hoangnguyen2000/my-proj/P41-22584 CUC CANH MOC KHOA W++/P41-22584 CUC CANH MOC KHOA W++.md

#### 1. Bản vẽ 

{expand}

<pdf>P41-22584 CUC CANH MOC KHOA W++.pdf</pdf>

{/expand}

#### 2. Tiêu chí kiểm tra đầu vào

##### 2.1. Kiểm tra ngoại quan
<table>
    <colgroup>
        <col width="100" />
        <col width="500" />
        <col width="500" />
    </colgroup>
    <tr>
        <th>STT</th>
        <th><center>Tiêu chí</center></th>
        <th><center>Hình ảnh</center></th>
    </tr>
    <tr>
        <td>1</td>
        <td>- Bề anode đen đều, không trầy xước<br /></td>
        <td>
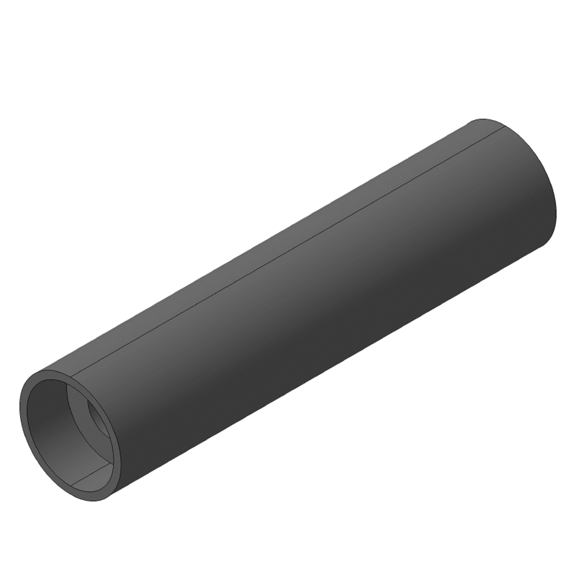
[picture p1: P41-22584 CUC CANH MOC KHOA W++/CUC CANH MOC KHOA W++.png]
            
        </td>
    </tr>
    <tr>
        <td>2</td>
        <td>- Đã xử lý bavia</td>
        <td></td>
    </tr>
</table>

##### 2.2. Kiểm tra kích thước chỉ định

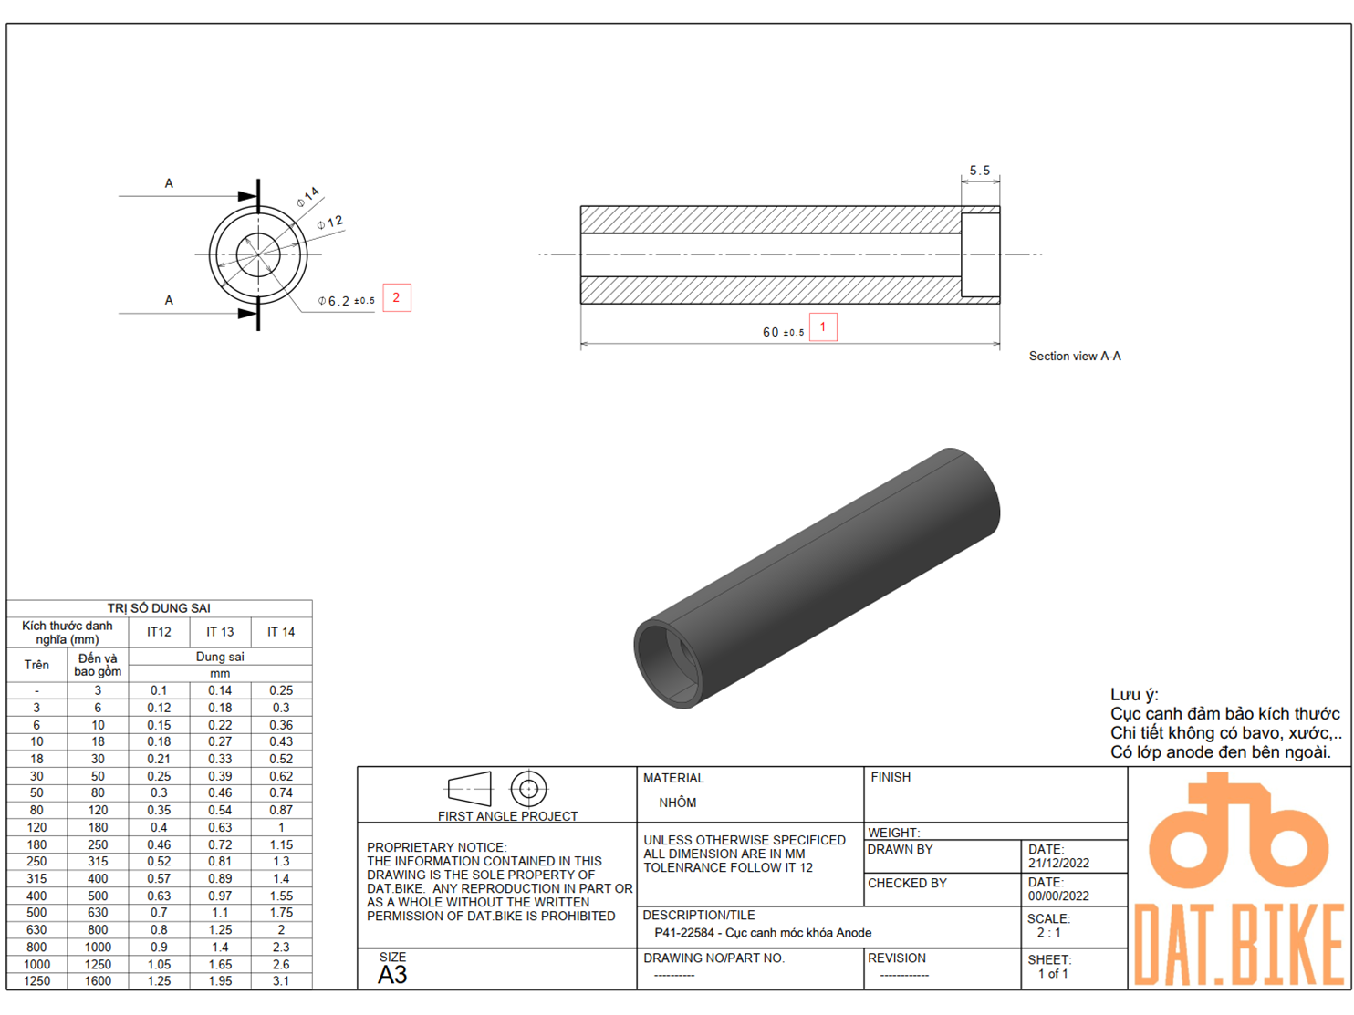
[picture p2: P41-22584 CUC CANH MOC KHOA W++/IQC CUC CANH MOC KHOA W++.png]


<table>
    <colgroup>
        <col width="100" />
        <col width="500" />
        <col width="275" />
        <col width="275" />
    </colgroup>
    <tr>
        <th>Điểm</th>
        <th><center>Kích thước</center></th>
        <th><center>Dung sai trên</center></th>
        <th><center>Dung sai dưới</center></th>
    </tr>
    <tr>
        <td><center>1</center></td>
        <td><center>60</center></td>
        <td><center>+0.5</center></td>
        <td><center>-0.5</center></td>
    </tr>
    <tr>
        <td><center>2</center></td>
        <td><center>6.2</center></td>
        <td><center>+0.5</center></td>
        <td><center>-0.5</center></td>
    </tr>
   
    </tr>
</table>

##### 2.3. Kiểm tra chức năng
<table>
    <colgroup>
        <col width="100" />
        <col width="500" />
    </colgroup>
    <tr>
        <th>STT</th>
        <th><center>Tiêu chí</center></th>
    </tr>
    <tr>
        <td>1</td>
        <td>- Lắp ráp vào Tab hộp sạc và móc treo đồ trên W++ </td>
    </tr>
</table>
