hoangnguyen2000/my-proj/P41-123 LOXO CHAN CHONG DUNG W++/P41-123 LOXO CHAN CHONG.md

#### 1. Bản vẽ 

{expand}

<pdf>PDF LO XO CHAN CHONG DUNG_LO_XO_CHAN_CHONG_DUNG_W++_V2_(105mm,phi3,16).pdf</pdf>

{/expand}

#### 2. Tiêu chí kiểm tra đầu vào

##### 2.1. Kiểm tra ngoại quan
<table>
    <colgroup>
        <col width="100" />
        <col width="500" />
        <col width="500" />
    </colgroup>
    <tr>
        <th>STT</th>
        <th><center>Tiêu chí</center></th>
        <th><center>Hình ảnh</center></th>
    </tr>
    <tr>
        <td>1</td>
        <td>- Bề mặt sơn đen nhám, không trầy xước<br /></td>
        <td>
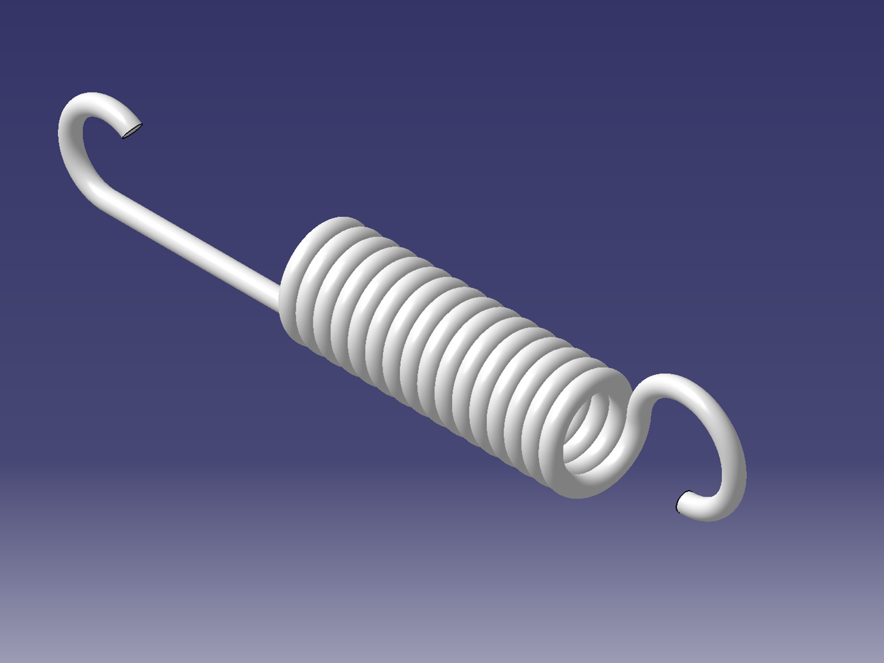
[picture p3: P41-123 LOXO CHAN CHONG DUNG W++/image (4).png]
            
        </td>
    </tr>
    <tr>
        <td>2</td>
        <td>- Đã xử lý bavia</td>
        <td></td>
    </tr>
</table>

##### 2.2. Kiểm tra kích thước chỉ định

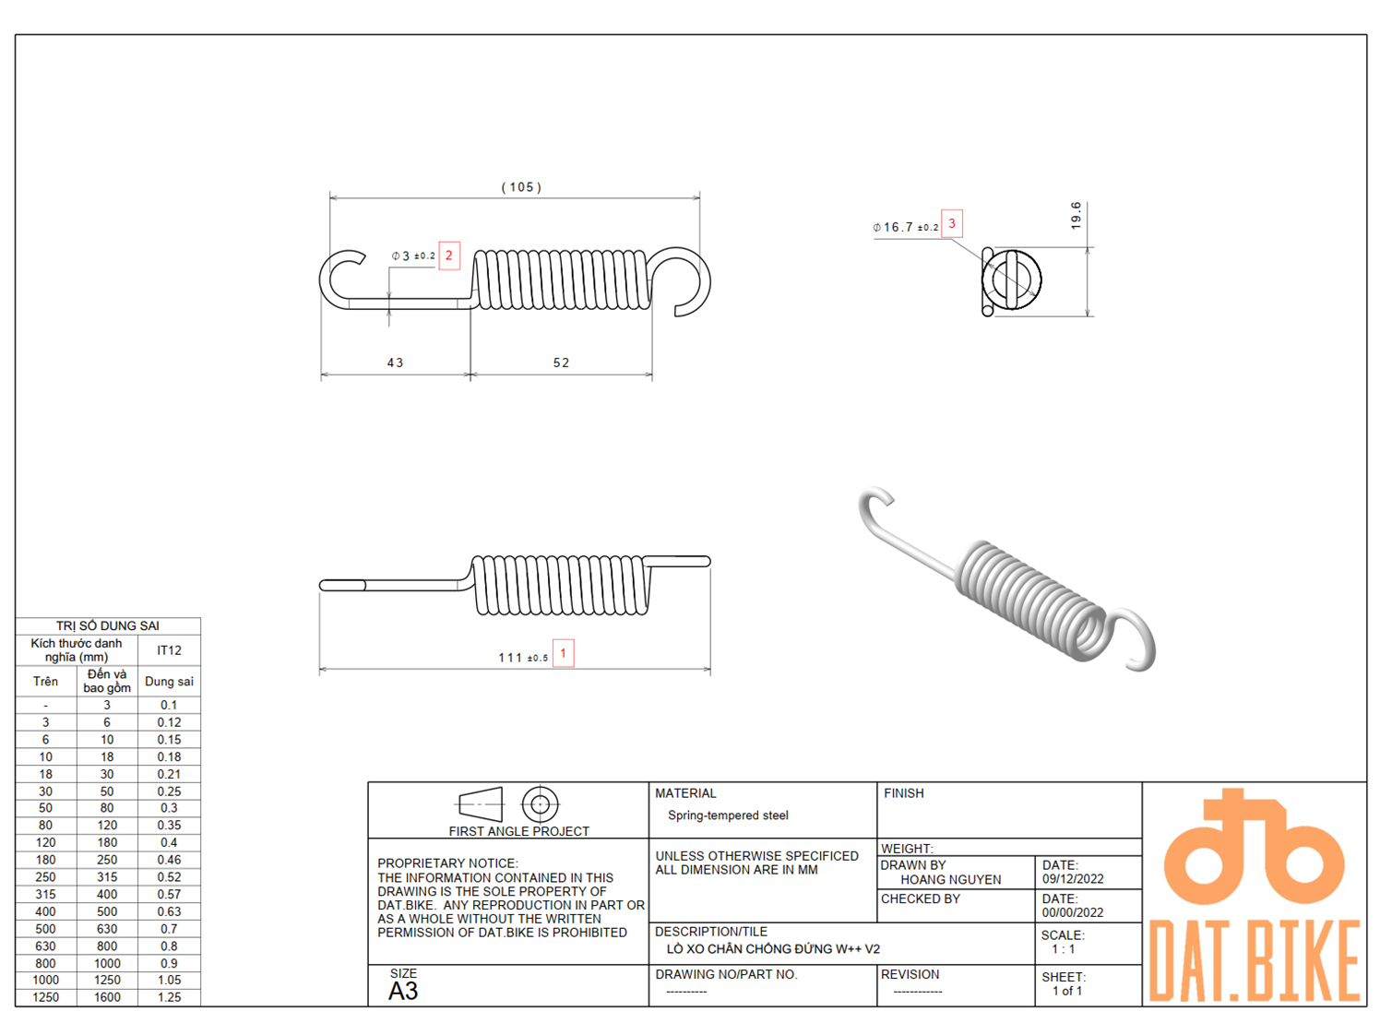
[picture p4: P41-123 LOXO CHAN CHONG DUNG W++/image (1).png]


<table>
    <colgroup>
        <col width="100" />
        <col width="500" />
        <col width="275" />
        <col width="275" />
    </colgroup>
    <tr>
        <th>Điểm</th>
        <th><center>Kích thước</center></th>
        <th><center>Dung sai trên</center></th>
        <th><center>Dung sai dưới</center></th>
    </tr>
    <tr>
        <td><center>1</center></td>
        <td><center>111</center></td>
        <td><center>+0.5</center></td>
        <td><center>-0.5</center></td>
    </tr>
    <tr>
        <td><center>2</center></td>
        <td><center>3</center></td>
        <td><center>+0.2</center></td>
        <td><center>-0.2</center></td>
    </tr>
   <tr>
        <td><center>3</center></td>
        <td><center>16.7</center></td>
        <td><center>+0.2</center></td>
        <td><center>-0.2</center></td>
    </tr>
    </tr>
</table>

##### 2.3. Kiểm tra chức năng
<table>
    <colgroup>
        <col width="100" />
        <col width="500" />
    </colgroup>
    <tr>
        <th>STT</th>
        <th><center>Tiêu chí</center></th>
    </tr>
    <tr>
        <td>1</td>
        <td>- Lắp rắp với chân chống đứng W++ và trục chân chống đứng </td>
    </tr>
</table>
