hoangnguyen2000/my-proj/P41-764940 OP NHONG DONG CO/P41-764940 op nhong truoc.md

#### 1. Bản vẽ 

{expand}

<pdf>PAD OP NHONG DONG CO_Sheet_1.pdf</pdf>

{/expand}

#### 2. Tiêu chí kiểm tra đầu vào

##### 2.1. Kiểm tra ngoại quan
<table>
    <colgroup>
        <col width="100" />
        <col width="500" />
        <col width="500" />
    </colgroup>
    <tr>
        <th>STT</th>
        <th><center>Tiêu chí</center></th>
        <th><center>Hình ảnh</center></th>
    </tr>
    <tr>
        <td>1</td>
        <td>- Bề mặt sơn đen nhám, không trầy xước<br /></td>
        <td>
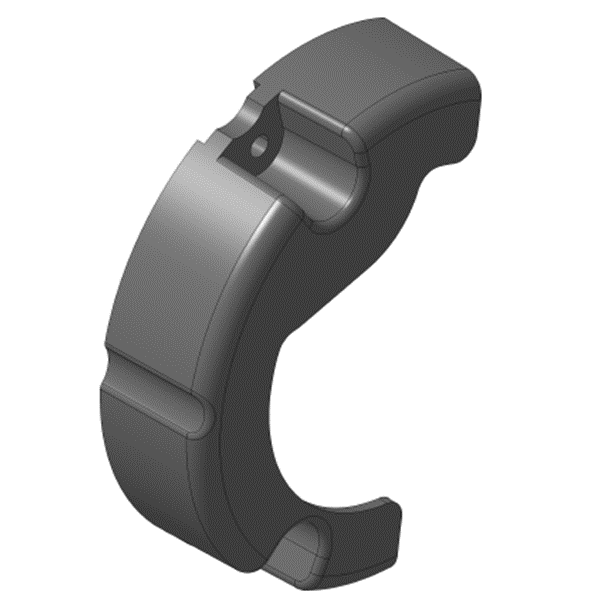
[picture p5: P41-764940 OP NHONG DONG CO/image (3).png]
            
        </td>
    </tr>
    <tr>
        <td>2</td>
        <td>- Đã xử lý bavia</td>
        <td></td>
    </tr>
</table>

##### 2.2. Kiểm tra kích thước chỉ định

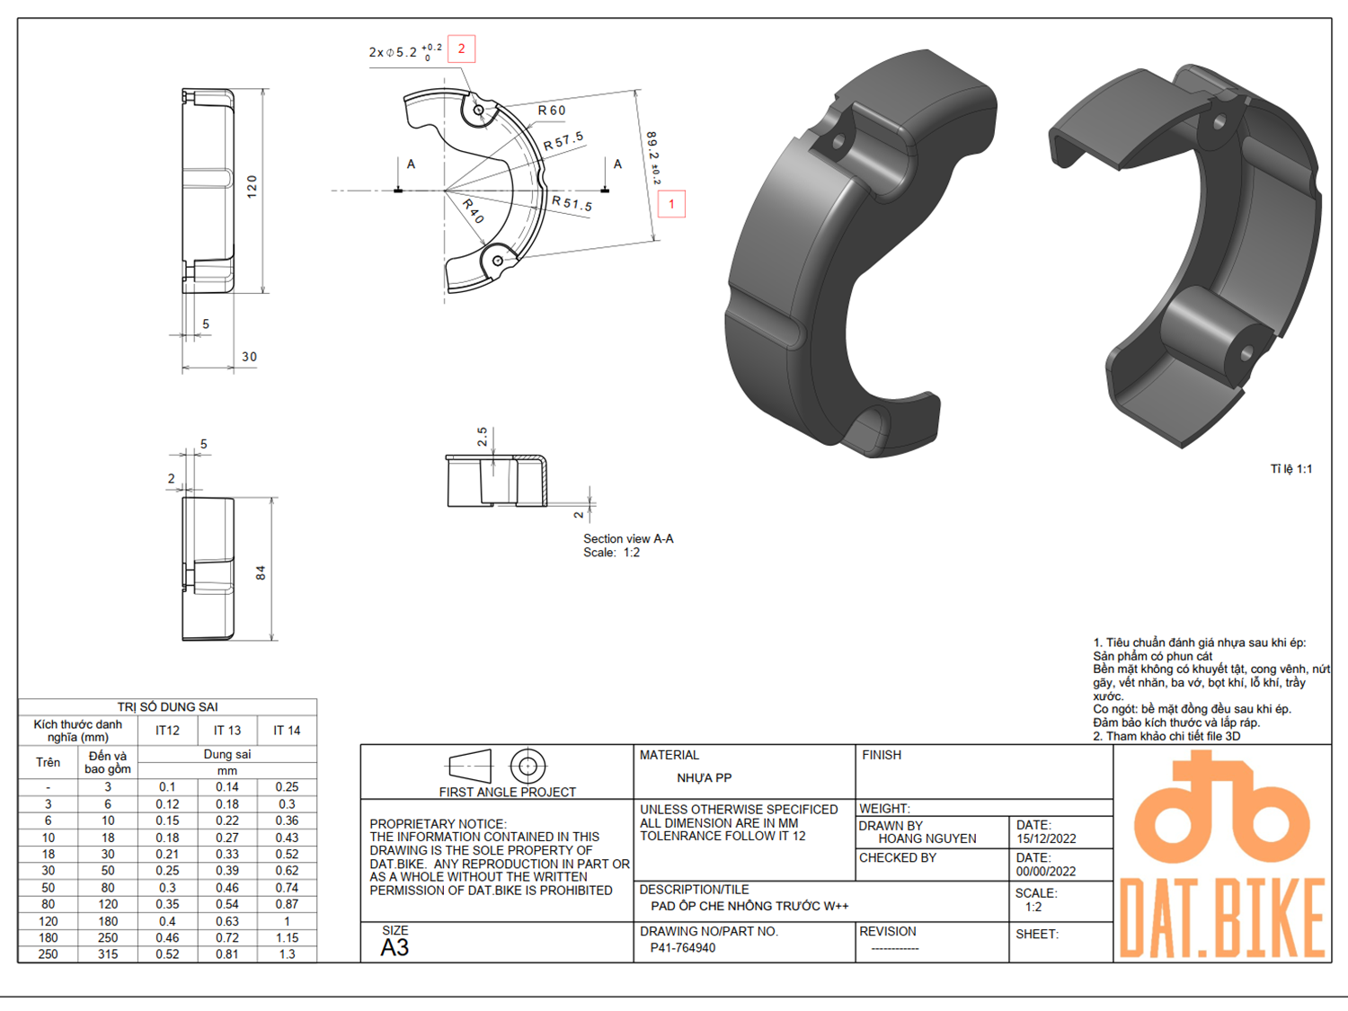
[picture p6: P41-764940 OP NHONG DONG CO/image (2).png]


<table>
    <colgroup>
        <col width="100" />
        <col width="500" />
        <col width="275" />
        <col width="275" />
    </colgroup>
    <tr>
        <th>Điểm</th>
        <th><center>Kích thước</center></th>
        <th><center>Dung sai trên</center></th>
        <th><center>Dung sai dưới</center></th>
    </tr>
    <tr>
        <td><center>1</center></td>
        <td><center>89.2</center></td>
        <td><center>+0.2</center></td>
        <td><center>-0.2</center></td>
    </tr>
    <tr>
        <td><center>2</center></td>
        <td><center>5.2</center></td>
        <td><center>+0.2</center></td>
        <td><center>0.0</center></td>
    </tr>
   
    </tr>
</table>

##### 2.3. Kiểm tra chức năng
<table>
    <colgroup>
        <col width="100" />
        <col width="500" />
    </colgroup>
    <tr>
        <th>STT</th>
        <th><center>Tiêu chí</center></th>
    </tr>
    <tr>
        <td>1</td>
        <td>- Lắp rắp với pad ốp nhông W++.</td>
    </tr>
</table>
