hoangnguyen2000/my-proj/P61 - Mold and Tooling/P61-319363 - GA KIEM TAB PHANH SAU W++/P61-319363 - GA KIEM TAB PHANH SAU W++.stp

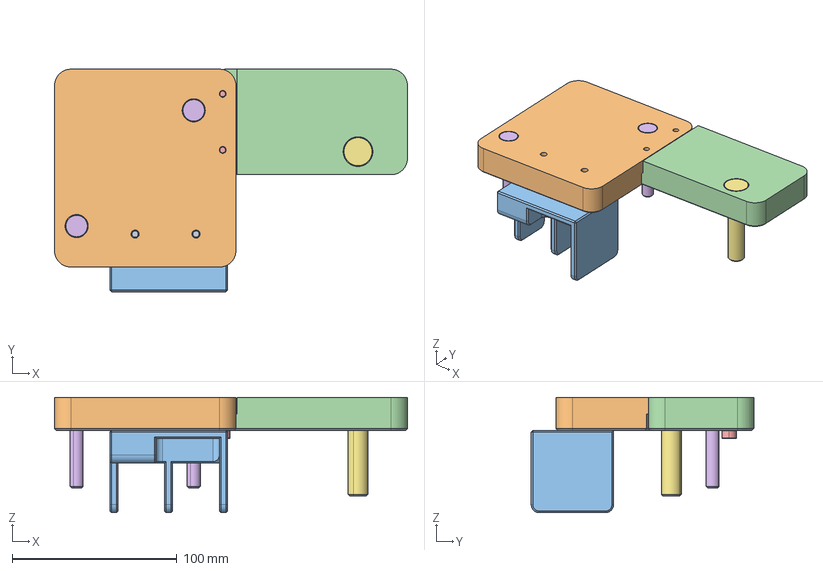
[picture p8: CAD file, 2022-12-09]
P61 - Mold and Tooling/P61-319363 - GA KIEM TAB PHANH SAU W++/P61-319363 - GA KIEM TAB PHANH SAU W++.stp
214.0 x 135.0 x 70.0 mm
M6x1 L 20 x 2
Tool and Jip Tab Phanh sau
JIP 02 TAB PHANH SAU
JIP 03 TAB PHANH SAU
Socket M5x15 x 2
TY DAY SKD61 (M8x60) x 2
TY DAY SKD61 (M12x60)
