hoangnguyen2000/my-proj/P61 - Mold and Tooling/P61-294621 - GA KIEM CHAN CHONG DUNG WEAVER++/Tool & jip kiem chan chong giua W200++_Sheet_3.pdf

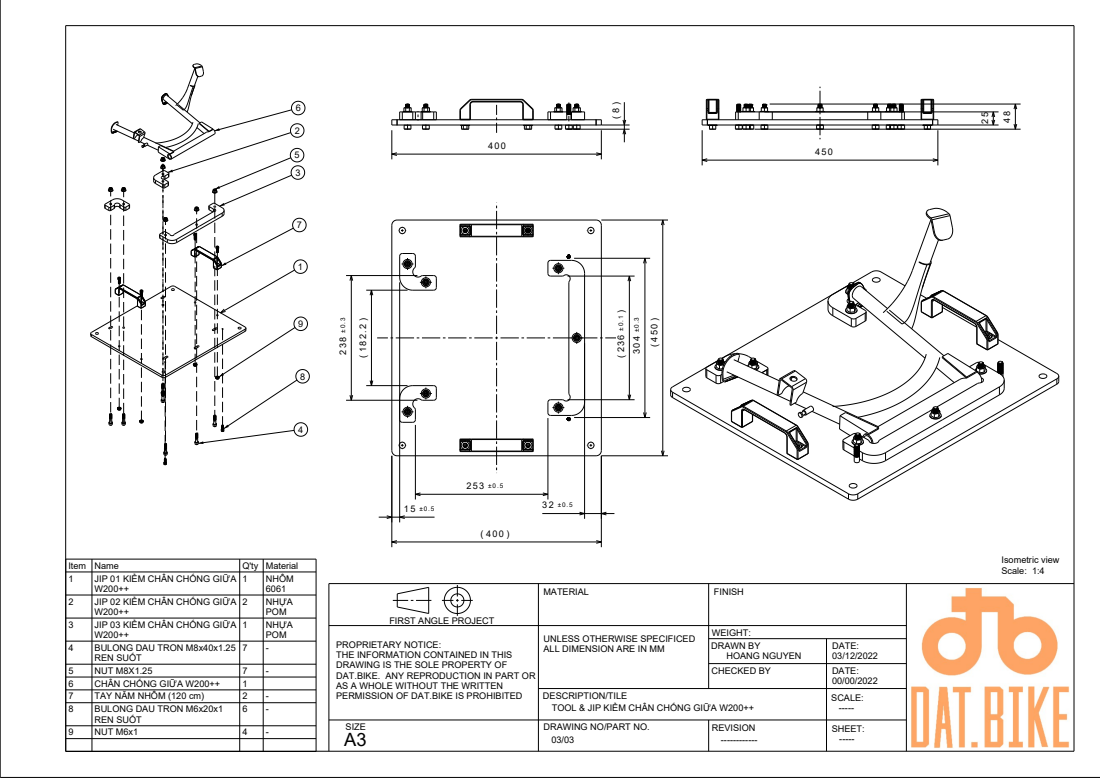
[picture p10: page 1]
DRAWN BY HOANG NGUYEN CHECKED BY; Isometric view Scale: 1:4; Item Name; Q'ty Material; 1 NHÔM 2 NHỰA 1 NHỰA 7 -; 5 NUT M8X1.25; 7 TAY NĂM NHÔM (120 cm); 9 NUT M6x1

1 JIP 01 KIỂM CHÂN CHỐNG GIỮA
2 JIP 02 KIỂM CHÂN CHỐNG GIỮA
3 JIP 03 KIỂM CHÂN CHỐNG GIỮA
4 BULONG DAU TRON M8x40x1.25
REN SUỐT
6 CHÂN CHỐNG GIỮA W200++ 1
8 BULONG DAU TRON M6x20x1

FIRST ANGLE PROJECT
PROPRIETARY NOTICE:
THE INFORMATION CONTAINED IN THIS
DRAWING IS THE SOLE PROPERTY OF
DAT.BIKE. ANY REPRODUCTION IN PART OR
AS A WHOLE WITHOUT THE WRITTEN
PERMISSION OF DAT.BIKE IS PROHIBITED

UNLESS OTHERWISE SPECIFICED
ALL DIMENSION ARE IN MM

DESCRIPTION/TILE
TOOL & JIP KIỂM CHÂN CHỐNG GIỮA W200++
DRAWING NO/PART NO.
