hoangnguyen2000/my-proj/P61 - Mold and Tooling/P61-808485 GA KIEM TAB HOP PIN PHIA SAU/CUM GA KIEM TAB HOP PIN PHIA SAU.pdf

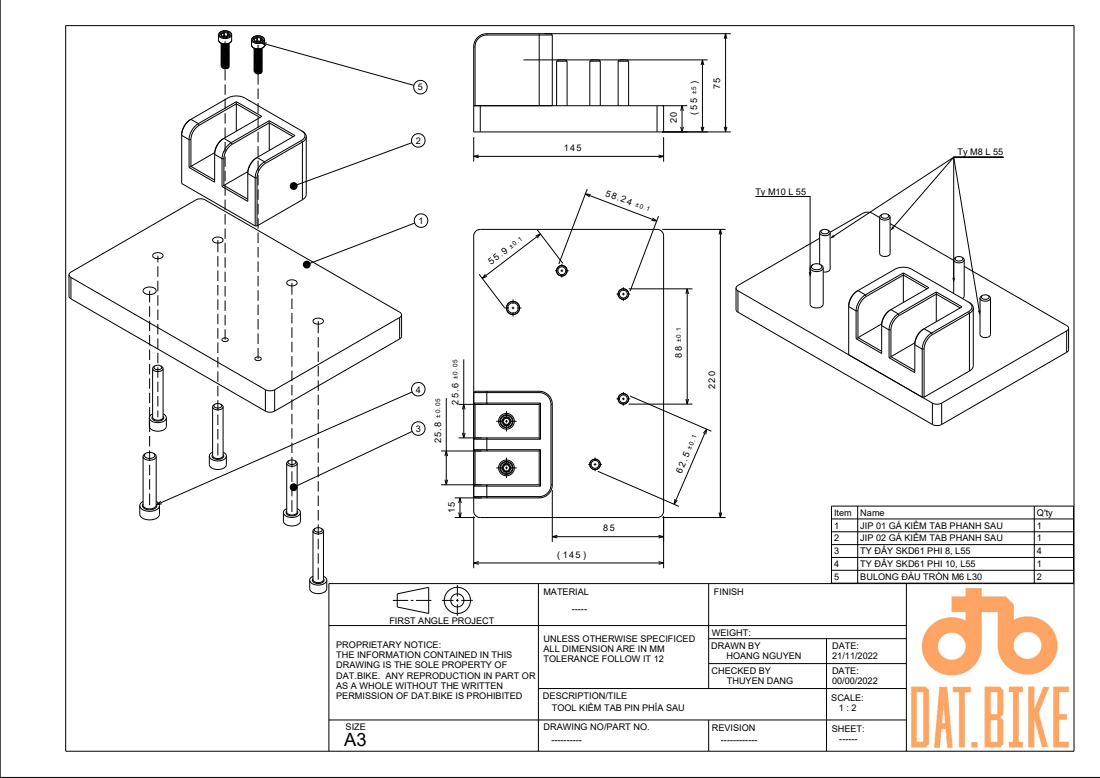
[picture p11: page 1]

1 | JIP 01 GÁ KIỂM TAB PHANH SAU | 1
2 3 | JIP 02 GÁ KIỂM TAB PHANH SAU TY ĐẨY SKD61 PHI 8, L55 | 1 4
4 | TY ĐẨY SKD61 PHI 10, L55 | 1
5 | BULONG ĐÀU TRÒN M6 L30 | 2

FIRST ANGLE PROJECT | | | | MATERIAL ----- | FINISH

PROPRIETARY NOTICE: THE INFORMATION CONTAINED IN THIS DRAWING IS THE SOLE PROPERTY OF DAT.BIKE. ANY REPRODUCTION IN PART OR AS A WHOLE WITHOUT THE WRITTEN PERMISSION OF DAT.BIKE IS PROHIBITED | | | | UNLESS OTHERWISE SPECIFICED ALL DIMENSION ARE IN MM TOLERANCE FOLLOW IT 12 | WEIGHT:

DRAWN BY HOANG NGUYEN | DATE: 21/11/2022
CHECKED BY THUYEN DANG | DATE: 00/00/2022

DESCRIPTION/TILE TOOL KIỂM TAB PIN PHÍA SAU | SCALE: 1 : 2

A3 SIZE | DRAWING NO/PART NO. ---------- | REVISION ------------ | SHEET: ------
