hoangnguyen2000/my-proj/P61 - Mold and Tooling/P61-808485 GA KIEM TAB HOP PIN PHIA SAU/JIP 02 GA KIEM TAB HOP PIN PHIA SAU.pdf

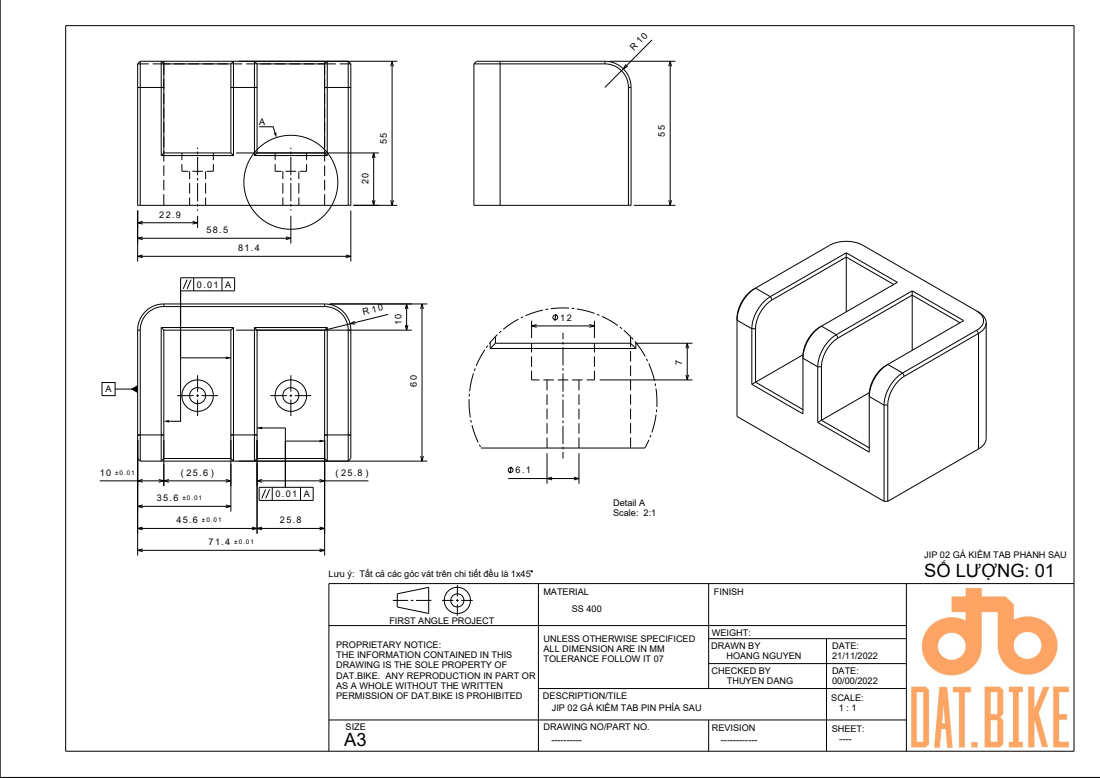
[picture p12: page 1]
Lưu ý: Tất cả các góc vát trên chi tiết đều là 1x45; SỐ LƯỢNG: 01; Detail A Scale: 2:1

JIP 02 GÁ KIỂM TAB PHANH SAU

FIRST ANGLE PROJECT | | | | MATERIAL SS 400 | FINISH

PROPRIETARY NOTICE: THE INFORMATION CONTAINED IN THIS DRAWING IS THE SOLE PROPERTY OF DAT.BIKE. ANY REPRODUCTION IN PART OR AS A WHOLE WITHOUT THE WRITTEN PERMISSION OF DAT.BIKE IS PROHIBITED | | | | UNLESS OTHERWISE SPECIFICED ALL DIMENSION ARE IN MM TOLERANCE FOLLOW IT 07 | WEIGHT:

DRAWN BY HOANG NGUYEN | DATE: 21/11/2022
CHECKED BY THUYEN DANG | DATE: 00/00/2022

DESCRIPTION/TILE JIP 02 GÁ KIỂM TAB PIN PHÍA SAU | SCALE: 1 : 1

A3 SIZE | DRAWING NO/PART NO. ---------- | REVISION ------------ | SHEET: ----
