hoangnguyen2000/my-proj/P41-22584 CUC CANH MOC KHOA W++/P41-22584 CUC CANH MOC KHOA W++.pdf

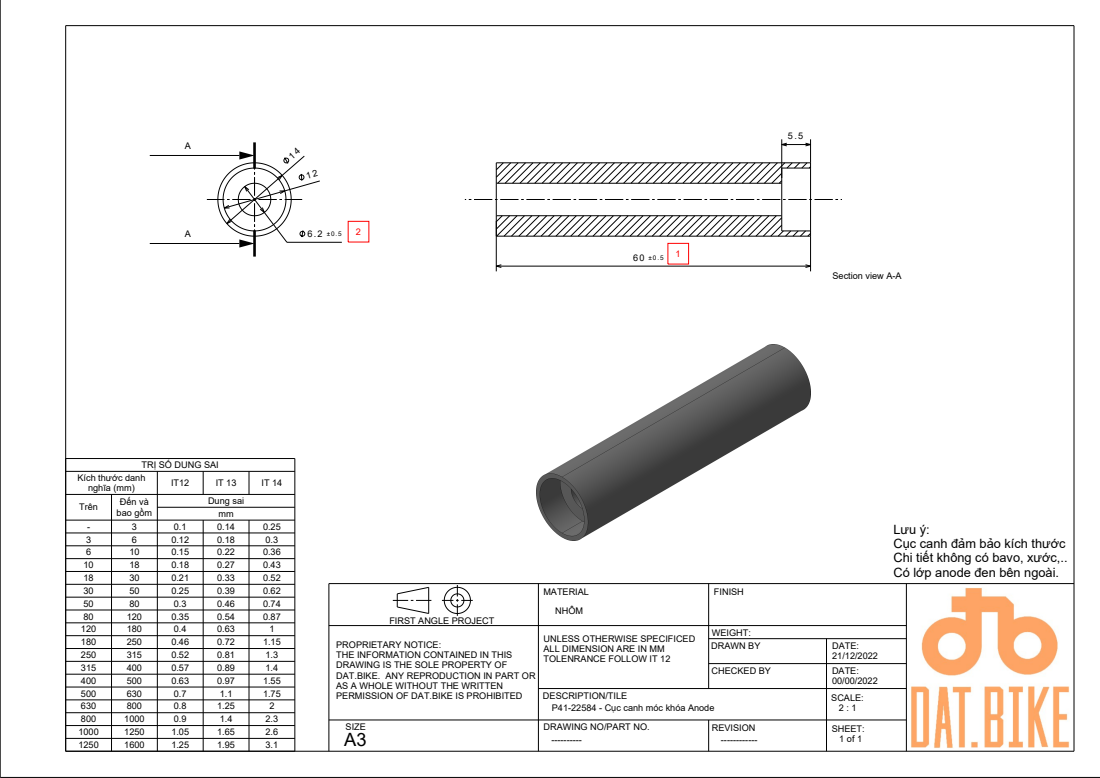
[picture p14: page 1]
CHECKED BY; Section view A-A

TRỊ SỐ DUNG SAI

Kích thước danh

nghĩa (mm) | IT12 | IT 13 Dung sai | IT 14
Trên | Đến và bao gồm | mm
3 | 6 | 0.12 | 0.18 | 0.3
6 | 10 | 0.15 | 0.22 | 0.36
10 | 18 | 0.18 | 0.27 | 0.43
18 | 30 | 0.21 | 0.33 | 0.52
30 | 50 | 0.25 | 0.39 | 0.62
80 | 120 | 0.35 | 0.54 | 0.87
120 | 180 | 0.4 | 0.63 | 1
180 | 250 | 0.46 | 0.72 | 1.15
250 | 315 | 0.52 | 0.81 | 1.3
315 | 400 | 0.57 | 0.89 | 1.4

Lưu ý:
Cục canh đảm bảo kích thước
Chi tiết không có bavo, xước,..
Có lớp anode đen bên ngoài.

FIRST ANGLE PROJECT

PROPRIETARY NOTICE: THE INFORMATION CONTAINED IN THIS DRAWING IS THE SOLE PROPERTY OF DAT.BIKE. ANY REPRODUCTION IN PART OR AS A WHOLE WITHOUT THE WRITTEN PERMISSION OF DAT.BIKE IS PROHIBITED | UNLESS OTHERWISE SPECIFICED ALL DIMENSION ARE IN MM TOLENRANCE FOLLOW IT 12 | WEIGHT:

DRAWN BY | DATE: 21/12/2022

DESCRIPTION/TILE
P41-22584 - Cục canh móc khóa Anode

800 | 1000 | 0.9 | 1.4 | 2.3
1250 | 1600 | 1.25 | 1.95 | 3.1

A3 SIZE | DRAWING NO/PART NO. ---------- | REVISION ------------ | SHEET:
