hoangnguyen2000/my-proj/P41-764940 OP NHONG DONG CO/PAD OP NHONG DONG CO_Sheet_1.pdf

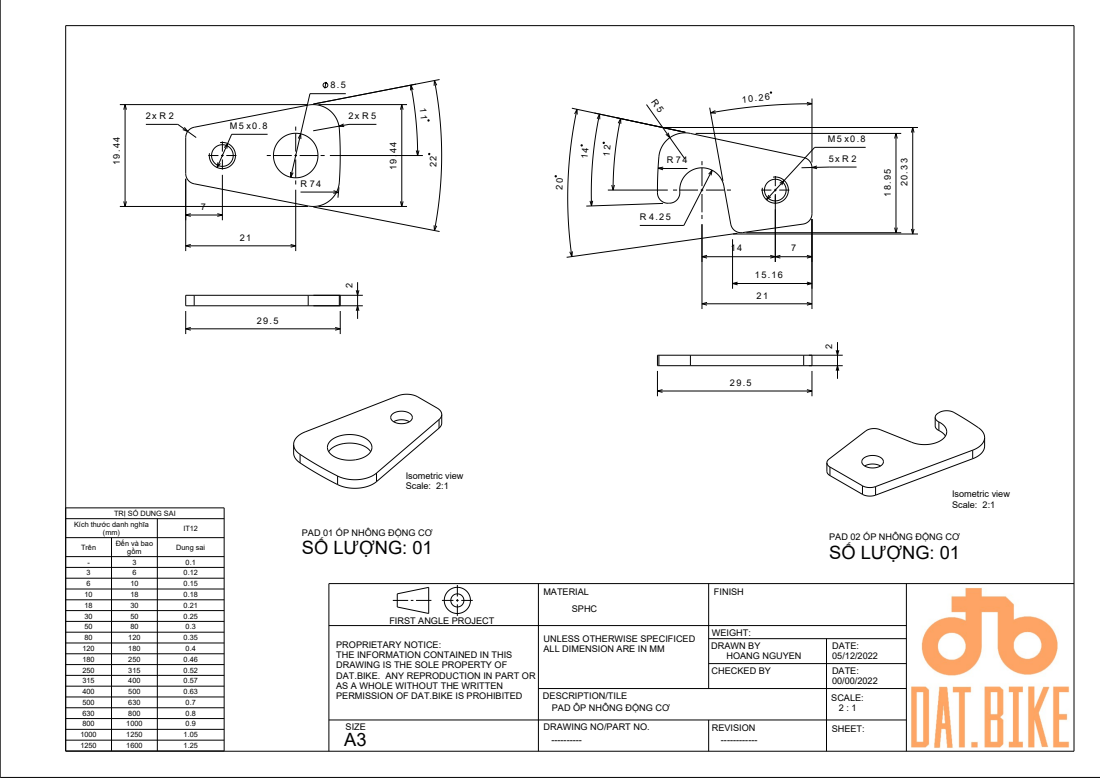
[picture p15: page 1]
CHECKED BY; Isometric view Scale: 2:1; Isometric view Scale: 2:1 SỐ LƯỢNG: 01; SỐ LƯỢNG: 01

TRỊ SỐ DUNG SAI

Kích thước danh nghĩa (mm) | IT12
Trên | Đến và bao gồm | Dung sai
-3 | 3 6 | 0.1 0.12
6 | 10 | 0.15
10 | 18 | 0.18
18 30 | 30 50 | 0.21 0.25
50 | 80 | 0.3
80 120 | 120 180 | 0.35 0.4
180 | 250 | 0.46

PAD 01 ỐP NHÔNG ĐỘNG CƠ

PAD 02 ỐP NHÔNG ĐỘNG CƠ

FIRST ANGLE PROJECT | MATERIAL SPHC | FINISH

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

DRAWN BY HOANG NGUYEN | DATE: 05/12/2022

400 | 500 | 0.63
500 630 | 630 800 | 0.7 0.8
800 | 1000 | 0.9
1000 1250 | 1250 1600 | 1.05 1.25

DESCRIPTION/TILE PAD ÔP NHÔNG ĐỘNG CƠ | SCALE: 2 : 1

A3 SIZE | DRAWING NO/PART NO. ---------- | REVISION ------------ | SHEET:
