hoangnguyen2000/my-proj/P41-764940 OP NHONG DONG CO/PAD OP NHONG DONG CO_Sheet_2.pdf

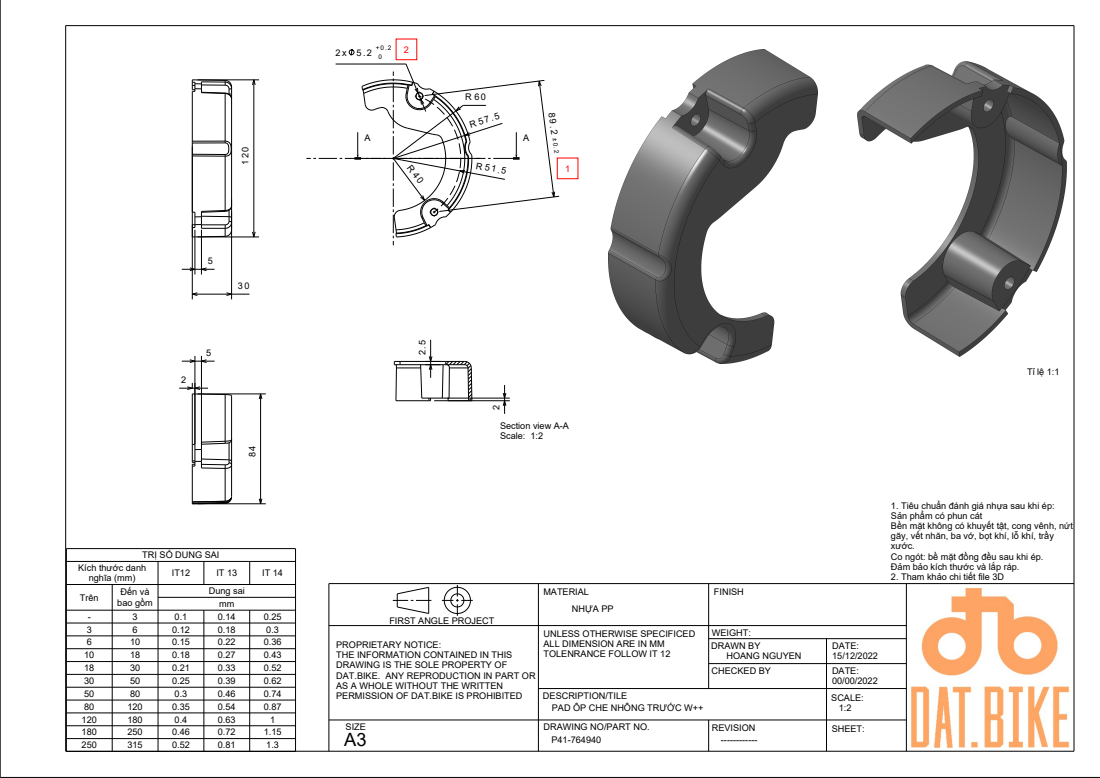
[picture p16: page 1]
CHECKED BY; NHỰA PP; nghĩa (mm); Trên; Đến và; Dung sai; Section view A-A Scale: 1:2

1. Tiêu chuẩn đánh giá nhựa sau khi ép:
Sản phẩm có phun cát
Bền mặt không có khuyết tật, cong vênh, nứt
gãy, vết nhăn, ba vớ, bọt khí, lỗ khí, trầy
xước.
Co ngót: bề mặt đồng đều sau khi ép.
Đảm bảo kích thước và lắp ráp.
2. Tham khảo chi tiết file 3D

TRỊ SỐ DUNG SAI
bao gồm

Kích thước danh

FIRST ANGLE PROJECT

3 | 6 | 0.12 | 0.18 | 0.3
6 | 10 | 0.15 | 0.22 | 0.36
10 | 18 | 0.18 | 0.27 | 0.43
18 | 30 | 0.21 | 0.33 | 0.52
50 | 80 | 0.3 | 0.46 | 0.74
120 180 | 180 250 | 0.4 0.46 | 0.63 0.72 | 1 1.15
250 | 315 | 0.52 | 0.81 | 1.3

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

DRAWN BY HOANG NGUYEN | DATE: 15/12/2022

DESCRIPTION/TILE
PAD ÔP CHE NHÔNG TRƯỚC W++

A3 SIZE | DRAWING NO/PART NO. P41-764940 | REVISION ------------ | SHEET:
