hoangnguyen2000/my-proj/P61 - Mold and Tooling/P61-294621 - GA KIEM CHAN CHONG DUNG WEAVER++/Tool & jip kiem chan chong giua W200++_Sheet_1.pdf

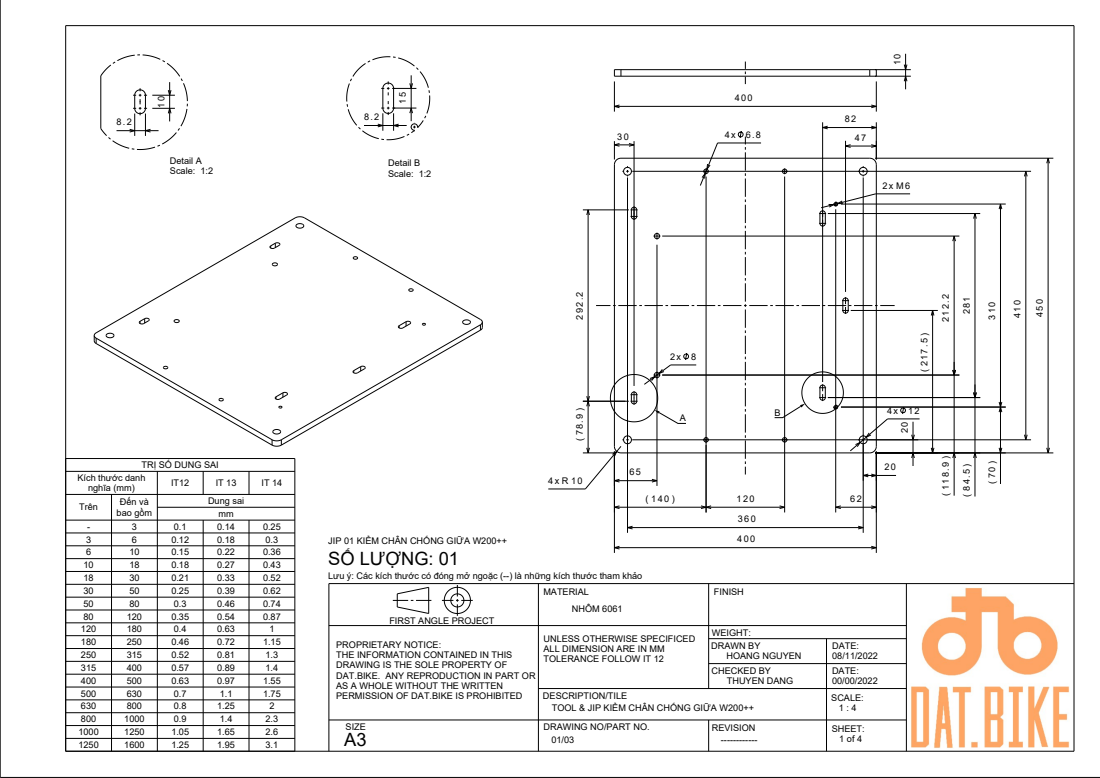
[picture p17: page 1]
CHECKED BY THUYEN DANG; NHÔM 6061; Detail A Scale: 1:2; Detail B Scale: 1:2

TRỊ SỐ DUNG SAI

Kích thước danh

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

JIP 01 KIỂM CHÂN CHỐNG GIỮA W200++
SỐ LƯỢNG: 01
Lưu ý: Các kích thước có đóng mở ngoặc (--) là những kích thước tham khảo

FIRST ANGLE PROJECT

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

DRAWN BY HOANG NGUYEN | DATE: 08/11/2022

DESCRIPTION/TILE
TOOL & JIP KIỂM CHÂN CHỐNG GIỮA W200++

800 | 1000 | 0.9 | 1.4 | 2.3
1250 | 1600 | 1.25 | 1.95 | 3.1

A3 SIZE | DRAWING NO/PART NO. 01/03 | REVISION ------------ | SHEET:
