hoangnguyen2000/my-proj/P61 - Mold and Tooling/P61-319363 - GA KIEM TAB PHANH SAU W++/CỤM JIP GÁ KIỂM TAB PHANH SAU.pdf

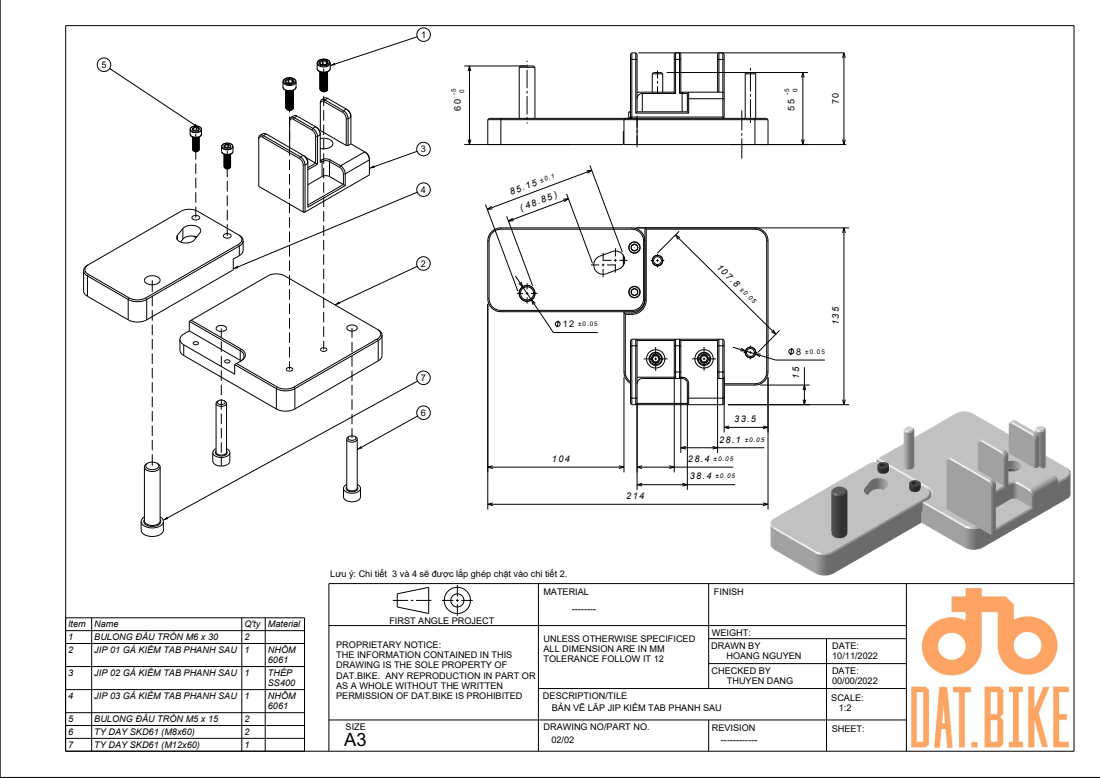
[picture p18: page 1]
BULONG ĐẦU TRÒN M5 x 15; TY DAY SKD61 (M8x60)

Lưu ý: Chi tiết 3 và 4 sẽ được lắp ghép chặt vào chi tiết 2.

FIRST ANGLE PROJECT | | MATERIAL -------- | FINISH

1 2 | BULONG ĐẦU TRÒN M6 x 30 JIP 01 GÁ KIỂM TAB PHANH SAU | 2 1 | NHÔM
3 | JIP 02 GÁ KIỂM TAB PHANH SAU | 1 | 6061 THÉP
4 | JIP 03 GÁ KIỂM TAB PHANH SAU | 1 | SS400 NHÔM

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

DRAWN BY HOANG NGUYEN | DATE: 10/11/2022
CHECKED BY THUYEN DANG | DATE: 00/00/2022

DESCRIPTION/TILE
BẢN VẼ LĂP JIP KIỂM TAB PHANH SAU

A3 SIZE | DRAWING NO/PART NO. 02/02 | REVISION ------------ | SHEET:

7 | TY DAY SKD61 (M12x60) | 1
