hoangnguyen2000/my-proj/P61 - Mold and Tooling/P61-319363 - GA KIEM TAB PHANH SAU W++/JIP 01 GÁ KIỂM TAB PHANH SAU.pdf

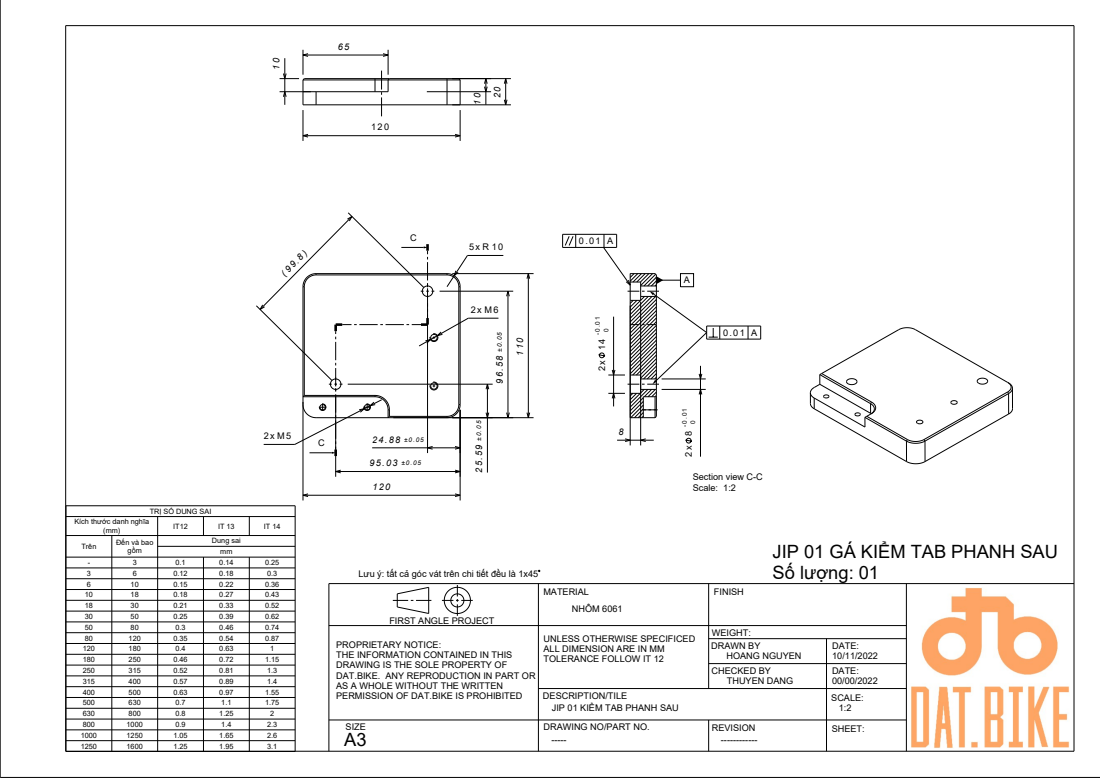
[picture p19: page 1]

Section view C-C
Scale: 1:2
JIP 01 GÁ KIỂM TAB PHANH SAU
Số lượng: 01

TRỊ SỐ DUNG SAI

Kích thước danh nghĩa

(mm) | IT12 | IT 13 Dung sai | IT 14
Trên | Đến và bao gồm
3 | 6 | 0.12 | 0.18 | 0.3
6 10 | 10 18 | 0.15 0.18 | 0.22 0.27 | 0.36 0.43
18 | 30 | 0.21 | 0.33 | 0.52
30 50 | 50 80 | 0.25 0.3 | 0.39 0.46 | 0.62 0.74
80 | 120 | 0.35 | 0.54 | 0.87
120 180 | 180 250 | 0.4 0.46 | 0.63 0.72 | 1 1.15
250 | 315 | 0.52 | 0.81 | 1.3
315 | 400 | 0.57 | 0.89 | 1.4

Lưu ý: tất cả góc vát trên chi tiết đều là 1x45

FIRST ANGLE PROJECT | MATERIAL NHÔM 6061 | FINISH

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

DRAWN BY HOANG NGUYEN | DATE: 10/11/2022
CHECKED BY THUYEN DANG | DATE: 00/00/2022

DESCRIPTION/TILE
JIP 01 KIỂM TAB PHANH SAU
DRAWING NO/PART NO.
