hoangnguyen2000/my-proj/P61 - Mold and Tooling/P61-319363 - GA KIEM TAB PHANH SAU W++/JIP 02 GÁ KIỂM TAB PHANH SAU.pdf

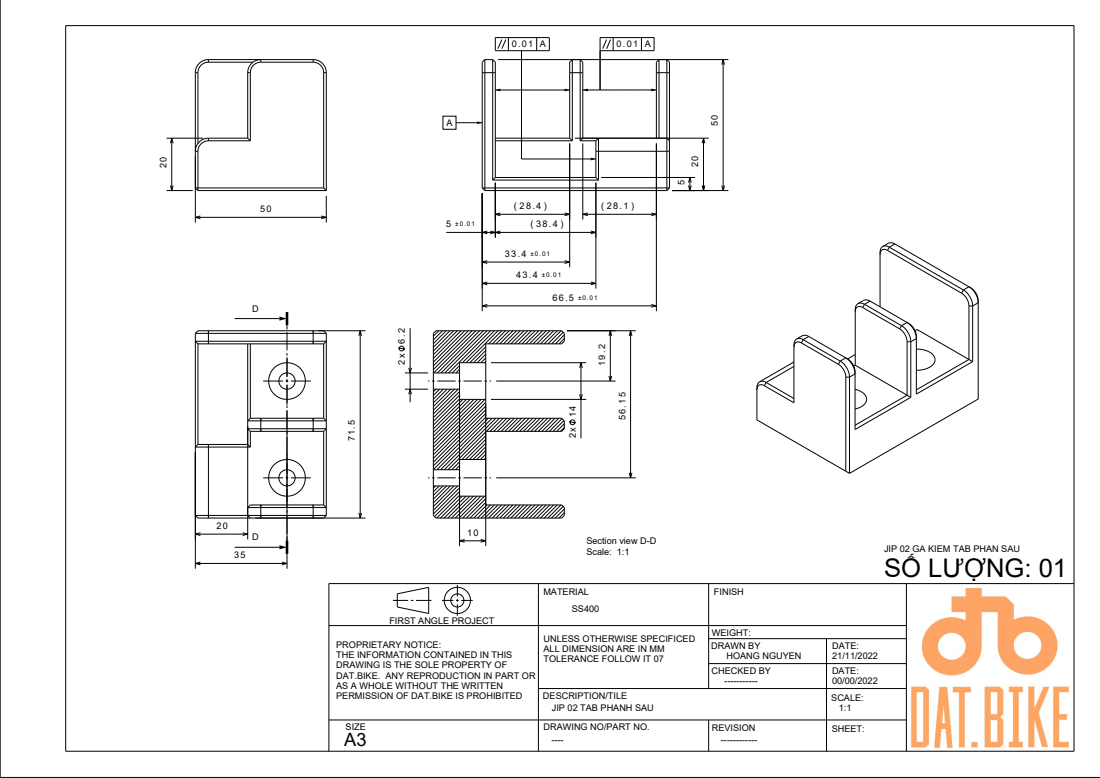
[picture p20: page 1]
Section view D-D Scale: 1:1

SỐ LƯỢNG: 01
JIP 02 GA KIEM TAB PHAN SAU

FIRST ANGLE PROJECT | | | | MATERIAL SS400 | FINISH

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

DRAWN BY HOANG NGUYEN | DATE: 21/11/2022
CHECKED BY ----------- | DATE: 00/00/2022

DESCRIPTION/TILE JIP 02 TAB PHANH SAU | SCALE: 1:1

A3 SIZE | DRAWING NO/PART NO. ---- | REVISION ------------ | SHEET:
