hoangnguyen2000/my-proj/P61 - Mold and Tooling/P61-649084-GA KIEM TAY VIN PHIA SAU W200++/CỤM LẮP GHÉP KIỂM TAY VỊN PHÍA SAU.pdf

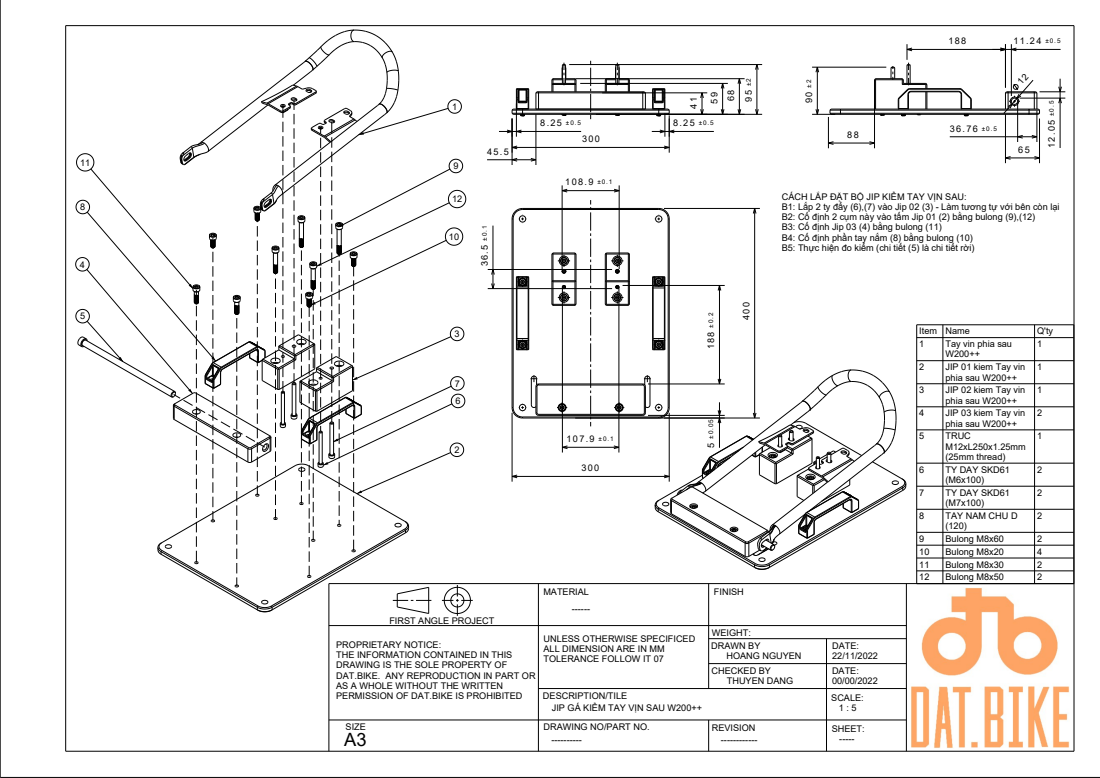
[picture p21: page 1]
DRAWN BY HOANG NGUYEN CHECKED BY THUYEN DANG; Item Name; 9 Bulong M8x60; 10 Bulong M8x20; 11 Bulong M8x30; 12 Bulong M8x50

CÁCH LẮP ĐẶT BỘ JIP KIỂM TAY VỊN SAU:
B1: Lắp 2 ty đẩy (6),(7) vào Jip 02 (3) - Làm tương tự với bên còn lại
B2: Cố định 2 cụm này vào tấm Jip 01 (2) bằng bulong (9),(12)
B3: Cố định Jip 03 (4) bằng bulong (11)
B4: Cố định phần tay nắm (8) bằng bulong (10)
B5: Thực hiện đo kiểm (chi tiết (5) là chi tiết rời)

1 Tay vin phia sau
2 JIP 01 kiem Tay vin
phia sau W200++
3 JIP 02 kiem Tay vin
4 JIP 03 kiem Tay vin
5 TRUC
(25mm thread)
6 TY DAY SKD61
7 TY DAY SKD61
8 TAY NAM CHU D

UNLESS OTHERWISE SPECIFICED
ALL DIMENSION ARE IN MM
TOLERANCE FOLLOW IT 07
DESCRIPTION/TILE
JIP GÁ KIỂM TAY VỊN SAU W200++
DRAWING NO/PART NO.

FIRST ANGLE PROJECT
PROPRIETARY NOTICE:
THE INFORMATION CONTAINED IN THIS
DRAWING IS THE SOLE PROPERTY OF
DAT.BIKE. ANY REPRODUCTION IN PART OR
AS A WHOLE WITHOUT THE WRITTEN
PERMISSION OF DAT.BIKE IS PROHIBITED
SIZE
