hoangnguyen2000/my-proj/P61 - Mold and Tooling/P61-649084-GA KIEM TAY VIN PHIA SAU W200++/JIP  KIỂM TAY VỊN PHÍA SAUW++.pdf

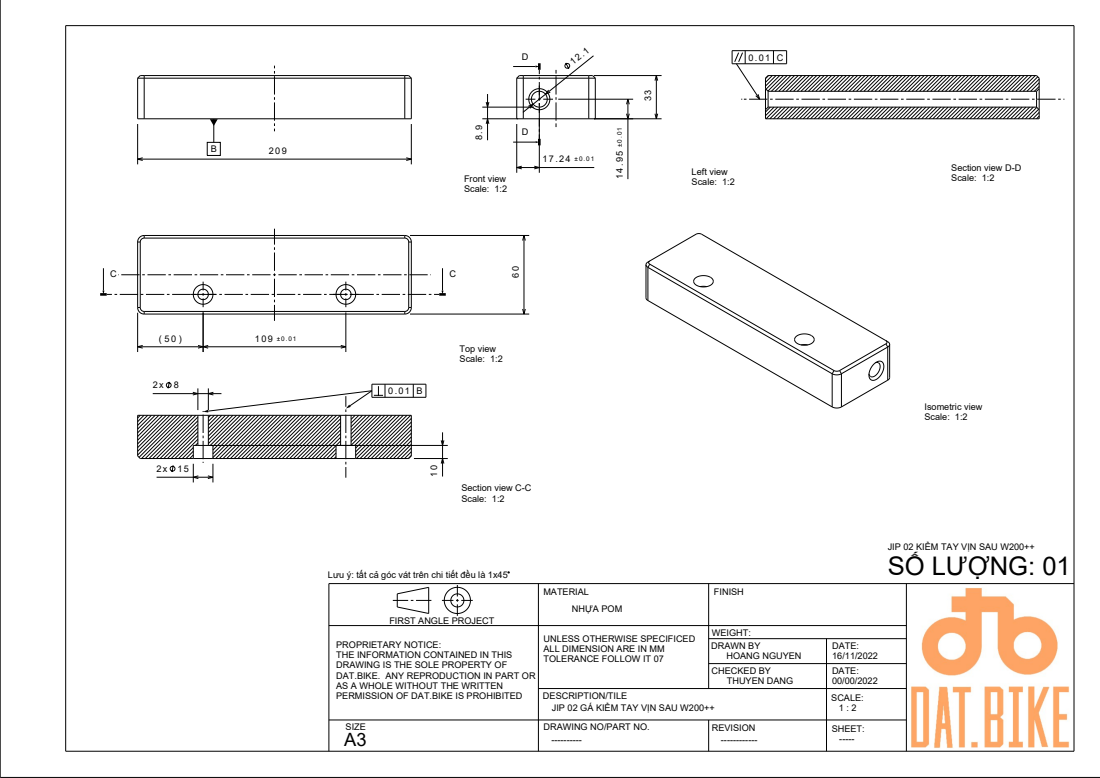
[picture p22: page 1]
Isometric view Scale: 1:2; Front view Scale: 1:2; Top view Scale: 1:2; Left view Scale: 1:2; Section view C-C Scale: 1:2; Section view D-D Scale: 1:2

SỐ LƯỢNG: 01
JIP 02 KIỂM TAY VỊN SAU W200++

Lưu ý: tất cả góc vát trên chi tiết đều là 1x45

FIRST ANGLE PROJECT | | | | MATERIAL NHỰA POM | FINISH

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

DRAWN BY HOANG NGUYEN | DATE: 16/11/2022
CHECKED BY THUYEN DANG | DATE: 00/00/2022

DESCRIPTION/TILE JIP 02 GÁ KIỂM TAY VỊN SAU W200++ | SCALE: 1 : 2

A3 SIZE | DRAWING NO/PART NO. ---------- | REVISION ------------ | SHEET: -----
