hoangnguyen2000/my-proj/P61 - Mold and Tooling/P61-649084-GA KIEM TAY VIN PHIA SAU W200++/JIP 01 KIỂM TAY VỊN PHÍA SAU W++.pdf

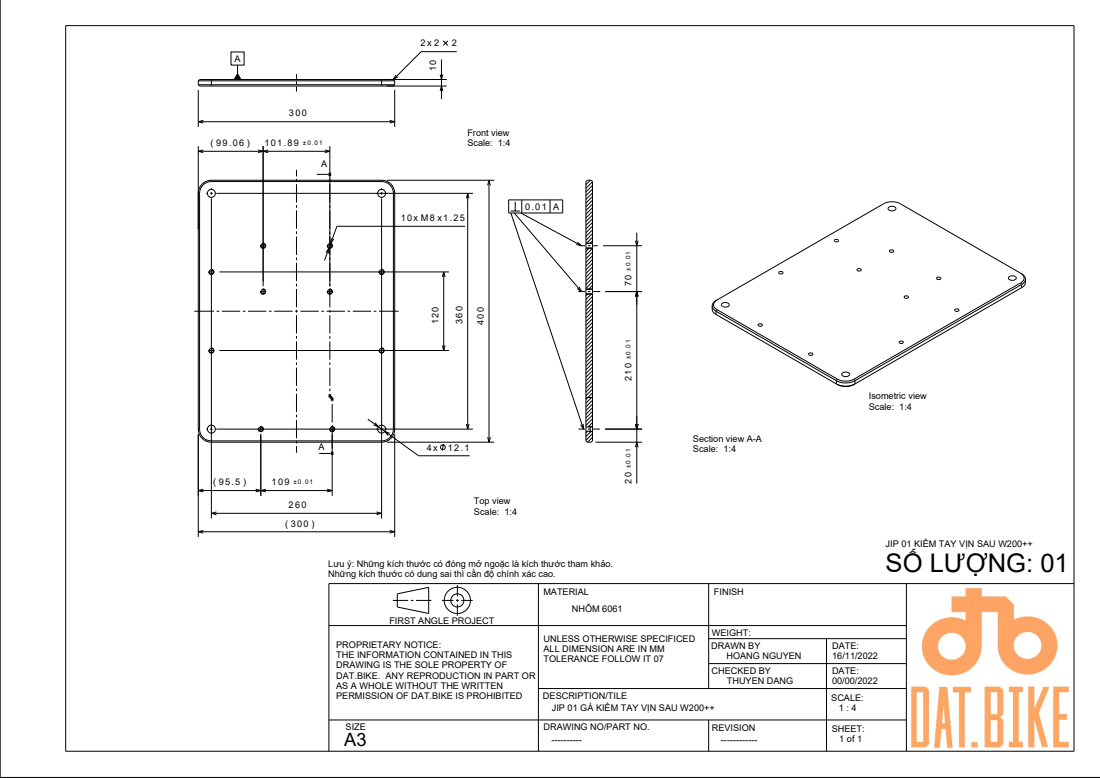
[picture p23: page 1]
Isometric view Scale: 1:4; Front view Scale: 1:4; Top view Scale: 1:4; Section view A-A Scale: 1:4

SỐ LƯỢNG: 01
JIP 01 KIỂM TAY VỊN SAU W200++

Lưu ý: Những kích thước có đóng mở ngoặc là kích thước tham khảo.
Những kích thước có dung sai thì cần độ chính xác cao.

FIRST ANGLE PROJECT | | | | MATERIAL NHÔM 6061 | FINISH

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

DRAWN BY HOANG NGUYEN | DATE: 16/11/2022
CHECKED BY THUYEN DANG | DATE: 00/00/2022

DESCRIPTION/TILE JIP 01 GÁ KIỂM TAY VỊN SAU W200++ | SCALE: 1 : 4

A3 SIZE | DRAWING NO/PART NO. ---------- | REVISION ------------ | SHEET:
