hoangnguyen2000/my-proj/P61 - Mold and Tooling/P61-649084-GA KIEM TAY VIN PHIA SAU W200++/JIP 03  KIỂM TAY VỊN PHÍA SAU W++.pdf

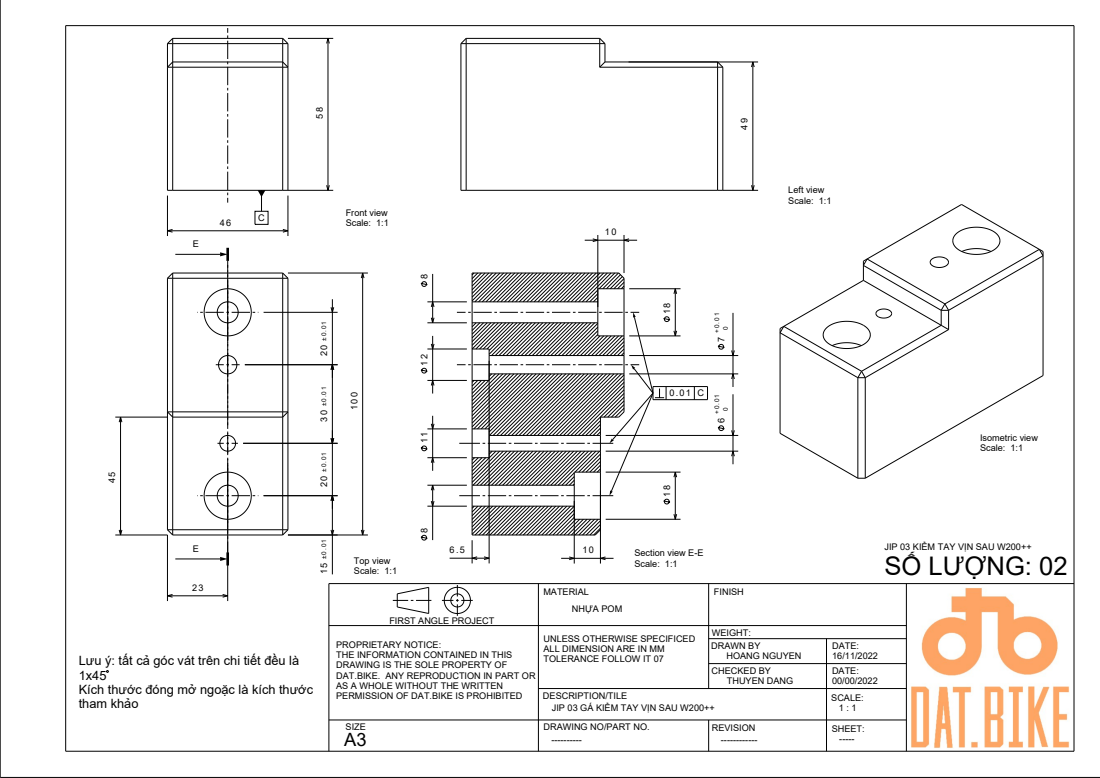
[picture p24: page 1]
Front view; Scale: 1:1 C; Top view Scale: 1:1; Left view Scale: 1:1; Section view E-E; Scale: 1:1

Isometric view
Scale: 1:1
SỐ LƯỢNG: 02
JIP 03 KIỂM TAY VỊN SAU W200++

FIRST ANGLE PROJECT | | | | MATERIAL NHỰA POM | FINISH

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

DRAWN BY HOANG NGUYEN | DATE: 16/11/2022
CHECKED BY THUYEN DANG | DATE: 00/00/2022

Lưu ý: tất cả góc vát trên chi tiết đều là
Kích thước đóng mở ngoặc là kích thước
tham khảo

DESCRIPTION/TILE JIP 03 GÁ KIỂM TAY VỊN SAU W200++ | SCALE: 1 : 1

A3 SIZE | DRAWING NO/PART NO. ---------- | REVISION ------------ | SHEET: -----
