hoangnguyen2000/my-proj/P61 - Mold and Tooling/P61-808485 GA KIEM TAB HOP PIN PHIA SAU/JIP 01 GA KIEM TAB HOP PIN PHIA SAU.pdf

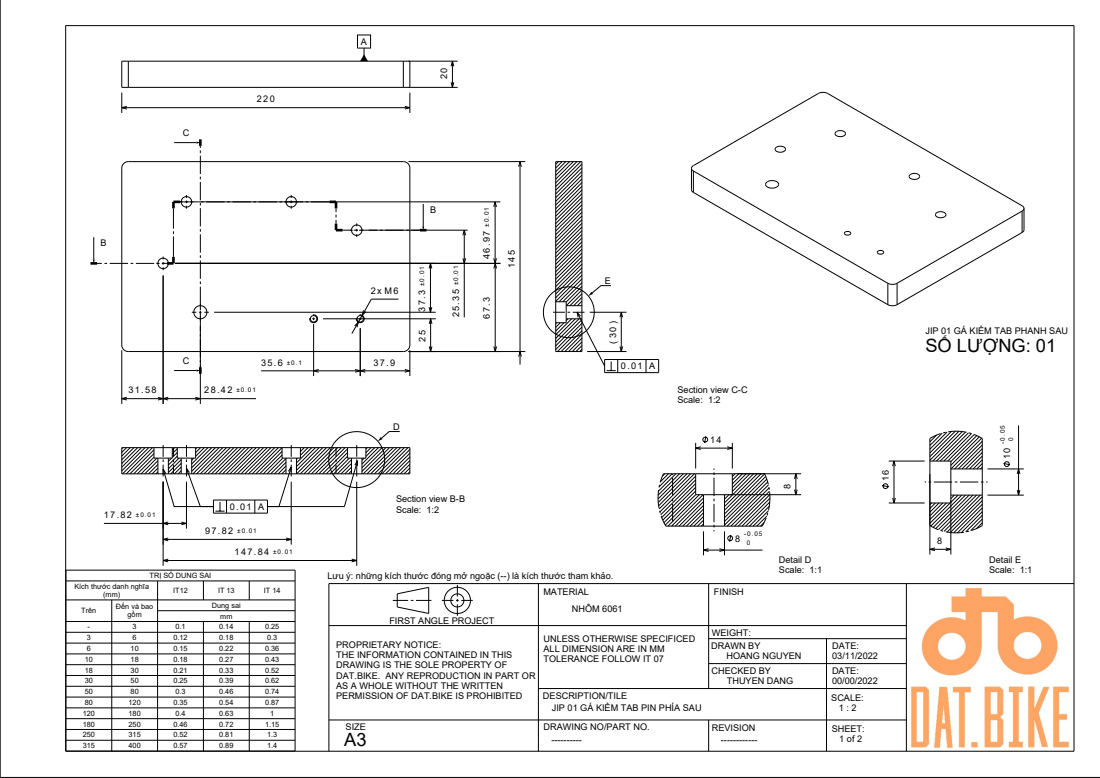
[picture p25: page 1]
CHECKED BY THUYEN DANG; Section view B-B; Scale: 1:2 0.01; Section view C-C Scale: 1:2; Detail D Scale: 1:1; Detail E Scale: 1:1

JIP 01 GÁ KIỂM TAB PHANH SAU
SỐ LƯỢNG: 01

TRỊ SỐ DUNG SAI

Lưu ý: những kích thước đóng mở ngoặc (--) là kích thước tham khảo.

Kích thước danh nghĩa

(mm) | IT12 | IT 13 | IT 14
Trên | Đến và bao gồm | Dung sai mm

FIRST ANGLE PROJECT | | MATERIAL NHÔM 6061 | FINISH

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

3 6 | 6 10 | 0.12 0.15 | 0.18 0.22 | 0.3 0.36
10 | 18 | 0.18 | 0.27 | 0.43

DRAWN BY HOANG NGUYEN | DATE: 03/11/2022

50 | 80 | 0.3 | 0.46 | 0.74
80 120 | 120 180 | 0.35 0.4 | 0.54 0.63 | 0.87 1
180 | 250 | 0.46 | 0.72 | 1.15
250 315 | 315 400 | 0.52 0.57 | 0.81 0.89 | 1.3 1.4

DESCRIPTION/TILE JIP 01 GÁ KIỂM TAB PIN PHÍA SAU | SCALE: 1 : 2

A3 SIZE | DRAWING NO/PART NO. ---------- | REVISION ------------ | SHEET:
