hoangnguyen2000/my-proj/(commit log)

2022-12-09 Add file tooling
    [P61-294621 - GA KIEM CHAN CHONG DUNG WEAVER++.stp, P61-319363 - GA KIEM TAB PHANH SAU W++.stp, R46-808485 GA KIEM TAB HOP PIN PHIA SAU.stp]
2022-12-21 BẢN VE IQC VÀ HÌNH ẢNH LÒ XO CHÂN CHỐNG ĐỨNG W++
2022-12-21 Chỉnh sửa lại file
2022-12-21 Thêm file Cục canh móc khóa W++
